wimberle/ME507-Term-Project/README.md

# ME507-Term-Project
This is the GitHub repository for the ME-507 Term Project at Cal Poly, SLO in spring 2023 under instructor Charlie Refvem
By: 
Matthew Wimberley and partner David Reo

The scope of this project was to create a robot for a competition of the game Hungry Hungry Hippos, where each robot must collect their team's respective color from an arena and deliver it to their respective home. A combination of line, ultrasonic, and color sensors in tandem with a custom designed PCB will accomplish this objective. The Bill of Materials, Schematic, PCB, Memorandum, and YouTube videos are outlined below.

## Reflection

While we fell short of our ambitious goal, this term project was ultimately very rewarding as I gained a new found respect for PCB manufacturing and the foresight that goes into designing well made boards. We were still able to get individual functionality of our line sensor, ultrasonic sensor, ball retrieving mechanism, and motor control as shown below.

## Bill of Materials

https://github.com/wimberle/ME507-Term-Project/blob/main/Bill%20of%20Materials.pdf

## Final Project Memorandum

https://github.com/wimberle/ME507-Term-Project/blob/main/Memorandum.pdf

## PCB & Schematic

https://github.com/wimberle/ME507-Term-Project/blob/main/SchematicAndPCB.pdf

## Top View of Final Results

https://github.com/wimberle/ME507-Term-Project/blob/main/IMG_4164.jpg

## YouTube Videos Demonstrating Our Robot's Functionalities
This video demonstrates line sensor functionality. 

https://youtu.be/W9VtT7H_Afg

This next video demonstates the capabilities of our DeadMan switch and ultrasonic sensor.

https://www.youtube.com/watch?v=X5WVTXg_MDY

This last video demonstrates the capabilities of our ball retrieving mechanism.

https://youtu.be/SO9tpv2Un_M
