wimberle/ME507-Term-Project/SchematicAndPCB.pdf

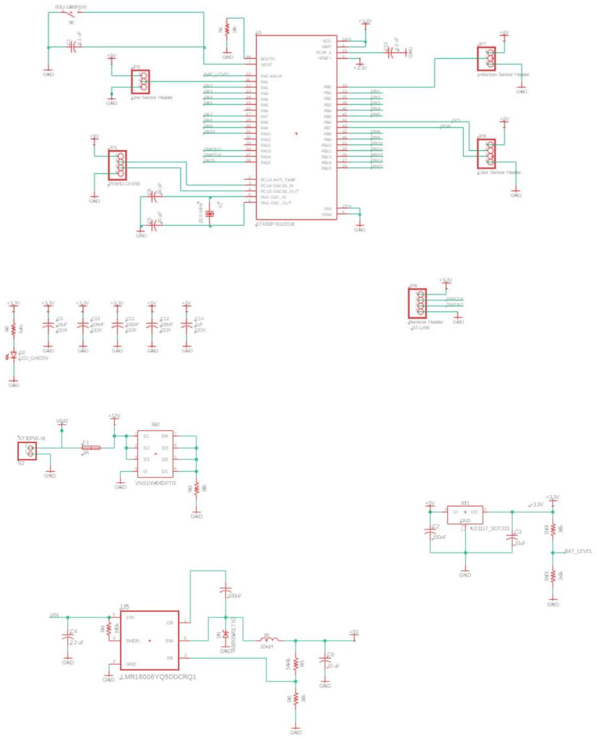
[picture p17: page 1]
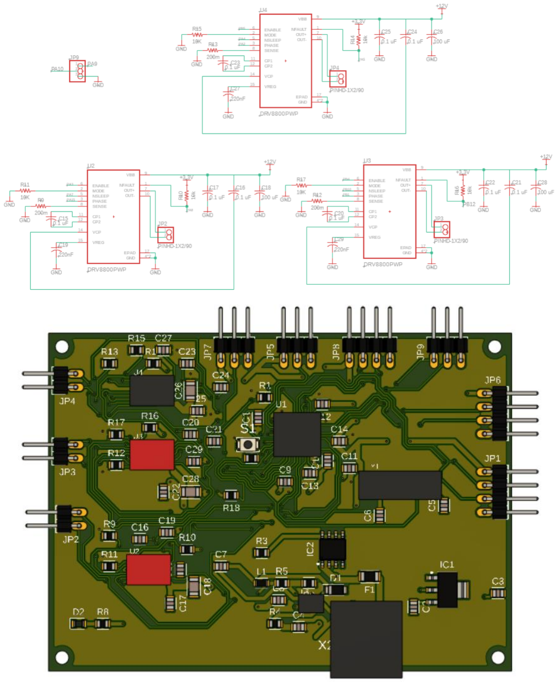
[picture p18: page 2]
