wimberle/ME507-Term-Project/Bill of Materials.pdf

Part | Quantity | Cost Per Part | Total Cost | Source
Wheels | 2 | $15 | 30 h ttp s://www.amazo n .co m/We ar-R e sistan t-Lu ggage -Su itcase -R e p lace me n t-Wh e e ls/d p /B 0 7 TVB C SG8 /re f= sr_ 1 _ 1 ?crid = 3 M GAQV6 EWZ5 6 V&ke ywo rd s= 3 + in ch + ru b b e r+ su itcase + wh e e l&q id = 1 6 8 1 6 9 5 5 7 7 &sp re fix= 3 + in ch + ru b b e r+ su itcase + wh e e l%2 C ap s%2 C 1 4 4 &sr= 8 -1 (https://www.amazon.com/Wear-Resistant-Luggage-Suitcase-Replacement-Wheels/dp/B07TVBCSG8)
Motor | 3 | $7 | 21 https://www.digikey.com/en/products/detail/johnson-motor/PC280LG-302/12723717
Solenoid | 1 | $10.00 | 10 h ttp s://www.amazo n .co m/M icro -Se rvo s-He lico p te r-Airp lan e -C o n tro ls/d p /B 0 7 M LR 1 4 9 8 /re f= sr_ 1 _ 1 3 ?crid = 3 B R 2 Z3 ISX G9 5 5 &ke ywo rd s= small%2 B me izu %2 B se rvo %2 B mo to r&q id = 1 6 8 5 0 5 0 5 8 2 &sp re fix= smallmie zu i%2 B se rvo %2 B mo to r%2 C ap s%2 C 1 2 4 &sr= 8 -1 3 &th = 1 (https://www.amazon.com/Micro-Servos-Helicopter-Airplane-Controls/dp/B07MLR1498)

# $24 for solenoid is a lot/find replacement

Battery | 1 | $19.52 | 19.52 https://www.digikey.com/en/products/detail/dantona-industries/L111A26-3-2-2WX/13692719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
Motor Driver | 3 | $3 | 9 https://www.digikey.com/en/products/detail/texas-instruments/DRV8800PWP/2231768
Ramp | 1 | $2 | 2 | 3D Print
Frame | 1 | $10 | 10 | 3D Print
Door | 1 | $3 | 5 | 3D Print
Line Detector | 1 | $3.50 | 3.5 ht t ps: / / www. digikey. com / en/ pr oduct s/ det ail/ spar kf un- elect r onics/ SEN- 11769/ 5768367?ut m _adgr oup=Evaluat ion%20Boar ds%20- %20Expansion%20Boar ds%2C%20Daught er %20Car ds&ut m _sour ce=google&ut m _m edium =cpc&ut m _cam paign=Shopping_Pr oduct _Developm ent %20Boar ds%2C%20Kit s%2C%20Pr ogr am m er s_NEW&ut m _t er m =&ut m _cont ent =Evaluat ion%20Boar ds%20- %20Expansion%20Boar ds%2C%20Daught er %20Car ds&gclid=CjwKCAjwue6hBhBVEiwA9YTx8LS0dkzGcZ3Wyx2eAM W9qquo8RI (https://www.digikey.com/en/products/detail/sparkfun-electronics/SEN-11769/5768367) f - m dxNuS_I pS9TbXvRE2NoE8XKhoCGVYQAvD_BwE
12V supply, cheap ultrasonic sensors exist but require two GPIO pins 1 | $10 | $10 | ht t ps: / / www. am azon. com / HC- SR04- HC- SR04P- Ult r asonic- Dist ance- M easur ing/ dp/ B07KNTQ4C2/ r ef =asc_df _B07KNTQ4C2/ ?t ag=hypr od- 20&linkCode=df 0&hvadid=647333030603&hvpos=&hvnet w=g&hvr and=2291005327543860054&hvpone=&hvpt wo=&hvqm t =&hvdev=c&hvdvcm dl=&hvlocint =&hvlocphy=1014232&hvt ar gid=pla- 2064869053590&psc=1&gclid=Cj0KCQjwyLGjBhDKARI sAFRNgW8m _aI EasnNRjI EwLBw6yC0RNSs2_7x5xQur pDTAC7FJ 7t HJ 2J uzr saAneGEALw_wcB (https://www.amazon.com/HC-SR04-HC-SR04P-Ultrasonic-Distance-Measuring/dp/B07KNTQ4C2?hvadid=647333030603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)
Color Detector | 1 | $8.70 | 8.7 ht t ps: / / www. digikey. com / en/ pr oduct s/ det ail/ seeed- t echnology- co. , - lt d/ 101020341/ 7423354?ut m _adgr oup=Seeed%20Technology%20Co. %2C%20LTD. &ut m _sour ce=google&ut m _m edium =cpc&ut m _cam paign=Shopping_DK%2BSupplier _Tier %201%20- %20Block%202&ut m _t er m =&ut m _cont ent =Seeed%20Technology%20Co. %2C%20LTD. &gclid=Cj0KCQjwj_ajBhCqARI sAA37s0zf F3wORvZOcQqSw- M SNSI s8Ed2EzgRBRlyFhDEt RLm 24Gm 5iKKlUQaAr BKEALw_wcB (https://www.digikey.com/en/products/detail/seeed-technology-co.,-ltd/101020341/7423354)
Transmitter/Receiver | 1 | $30 | $30 | h ttp s://www.amazo n .co m/HOB B YFANS-An ti-Jammin g-C o n tro l-Tran smitte r-R e ce ive r/d p /B 0 9 QHS9 4 NV/re f= sr_ 1 _ 7 ?crid = 1 I3 DGH5 3 E3 K 1 Z&ke ywo rd s= 2 + ch an n e l+ rc+ tran smitte r+ an d + re ce ive r&q id = 1 6 8 2 9 7 0 3 7 1 &sp re fix= 2 + ch an n e l+ rc+ tran smitte r+ an d + re ce ive r%2 C ap s%2 C 4 1 0 &sr= 8 -7 (https://www.amazon.com/HOBBYFANS-Anti-Jamming-Control-Transmitter-Receiver/dp/B09QHS94NV)
MOSFET | 1 | $1.28 | $1.28 | https://www.digikey.com/en/products/detail/diodes-incorporated/DMP2022LSS-13/1934991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
FUSE | 1 | $0.54 | $0.54 | https://www.digikey.com/en/products/detail/panasonic-electronic-components/ERB-RG3R00V/4280109
battery connector (XT-30) | 1 | $10.00 | $10.00 | ht t ps: / / www. am azon. com / OliYin- Connect or - Bat t er y- Air plane- Quadcopt er / dp/ B07P8M 44ZX/ r ef =sr _1_3_sspa?cr id=3V3M M FJ GXGJ BN&keywor ds=xt 30+connect or &qid=1683349130&s=t oys- and- gam es&spr ef ix=xt 30+connec%2Ct oys- and- gam es%2C459&sr =1- 3- spons&psc=1&spLa=ZW5jcnlwdGVkUXVhbGlm aWVyPUEySzJ EVEZYNE9I R1dVJ m VuY3J 5cHRlZElkPUEwM zA2M Tc5M 1BaT1BURUZES1QxWCZlbm NyeXB0ZWRBZElkPUEwNTM xODM wM UUyR0NBQ0J ZT0Um d2lkZ2V0Tm Ft ZT1zcF9hdGYm YWN0aW9uPWNsaWNr (https://www.amazon.com/OliYin-Connector-Battery-Airplane-Quadcopter/dp/B07P8M44ZX?s=toys-and-games) Um VkaXJ lY3Qm ZG9Ob3RM b2dDbGljaz10cnVl
Crystal | 1 | $0.20 | $0.20 | https://www.digikey.com/en/products/detail/ecs-inc/ECS-200-20-5PX-TR/696734
Linear regulator (5-3.3) | 1 | $0.66 | $0.66 | https://www.digikey.com/en/products/detail/stmicroelectronics/LD1117S33CTR/585765
capacitor for linear (1 uF) | 3 | $0.10 | $0.30 | https://www.digikey.com/en/products/detail/samsung-electro-mechanics/CL21B105KAFNNNE/3886724
Switcher (12V-5V) | 1 | $3.74 | $3.74 | https://www.digikey.com/en/products/detail/texas-instruments/LMR16006YQ5DDCRQ1/5395815
2.2 uF Cap | 5 | $0.10 | $0.50 | https://www.digikey.com/en/products/detail/samsung-electro-mechanics/CL21B225KAFNFNE/3888611
100 nF Cap | 10 | $0.10 | $1.00 | https://www.digikey.com/en/products/detail/samsung-electro-mechanics/CL21B104KBCNNNC/3886661
20 pF Cap | 5 | $0.10 | $0.50 | https://www.digikey.com/en/products/detail/kemet/C0805C200J5HAC7800/7948475
10 uF Cap | 10 | $0.10 | $1.00 | https://www.digikey.com/en/products/detail/samsung-electro-mechanics/CL21A106KOQNNNE/3886754
Resistor, 100k | 3 | $0.10 | $0.30 | https://www.digikey.com/en/products/detail/panasonic-electronic-components/ERA-6AEB104V/1465797
resistor, 10k | 10 | $0.10 | $1.00 | https://www.digikey.com/en/products/detail/yageo/RC0805JR-0710KL/728241
Resistor, 3.3k | 3 | $0.10 | $0.30 https://www.digikey.com/en/products/detail/te-connectivity-passive-product/CRGCQ0805J3K3/8576739
Resistor, 54.9k | 5 | $0.10 | $0.50 | https://www.digikey.com/en/products/detail/yageo/RC0805FR-0754K9L/728029
Resistor, 200m | 5 | $0.30 | $1.50 https://www.digikey.com/en/products/detail/susumu/RL1220S-R20-F/432484
100 uF Cap | 10 | $0.44 | $4.40 https://www.digikey.com/en/products/detail/murata-electronics/GRM31CD80J107MEA8K/13905021
Reset Switch | 1 | $1.00 | $1.00 | https://www.digikey.com/en/products/detail/omron-electronics-inc-emc-div/B3U-1000P/1534338
Inductor, 10 mH | 1 | $3.03 | $3.03 | https://www.digikey.com/en/products/detail/taiyo-yuden/LBR2012T100K/1788937
Schottkey Diode | 1 | $0.36 | $0.36 | https://www.digikey.com/en/products/detail/diodes-incorporated/FES1DE/16375492
LED | 3 | $0.28 | $0.84 | https://www.digikey.com/en/products/detail/liteon/LTST-C171KGKT/386799
3 pin header | 4 | $1.63 | $6.52 https://www.digikey.com/en/products/detail/mill-max-manufacturing-corp/380-10-103-00-002000/8019516
2 pin header | 4 | $1.23 | $4.92 https://www.digikey.com/en/products/detail/mill-max-manufacturing-corp/380-10-102-00-002000/8019515
4 pin header | 4 | $1.80 | $7.20 https://www.digikey.com/en/products/detail/mill-max-manufacturing-corp/380-10-104-00-002000/8019517
Grand Total | 95 | | $198.19
