wimberle/ME507-Term-Project/main.c

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
/* Includes ------------------------------------------------------------------*/
#include "main.h"

/* USER CODE BEGIN Includes */
#include "motor_driver.h"
#include "string.h"
#include "stdio.h"
#include "ctype.h"


/* USER CODE END Includes */

I2C_HandleTypeDef hi2c1;

TIM_HandleTypeDef htim1;
TIM_HandleTypeDef htim2;
TIM_HandleTypeDef htim5;

void SystemClock_Config(void);
static void MX_GPIO_Init(void);
static void MX_TIM2_Init(void);
static void MX_TIM1_Init(void);
static void MX_I2C1_Init(void);
static void MX_TIM5_Init(void);
/* USER CODE BEGIN 0 */
void delay (uint16_t time)
{
	__HAL_TIM_SET_COUNTER(&htim1, 0);
	while (__HAL_TIM_GET_COUNTER (&htim1) < time);
}

uint32_t IC_Val1 = 0;
uint32_t IC_Val2 = 0;
uint32_t Difference = 0;
uint8_t Is_First_Captured = 0;
uint8_t Is_Dead = 0;
uint8_t Start = 0;
uint32_t trig = 0;
uint8_t Distance = 0;
uint8_t L1 = 0;
uint8_t L2 = 0;

#define TRIG_PIN GPIO_PIN_9 // make sure this is A9
#define TRIG_PORT GPIOA
#define LS_PORT GPIOB
#define LS_1 GPIO_PIN_9
#define LS_2 GPIO_PIN_8


void HAL_TIM_IC_CaptureCallback(TIM_HandleTypeDef *htim)
// figure out how to put the dead man's switch in this same callback
{

	if (htim == &htim5) //timer 5 is for dead man's switch
	{
		// maybe do a further check for channel
		trig = HAL_TIM_ReadCapturedValue(&htim5, TIM_CHANNEL_2)/100; // has to be on channel 2
		if (trig > 1700)
		{
			Is_Dead = 1;
			// some other code to kill the robot
			// maybe turn off motor drivers
		}
		if (trig < 1000 && trig!=0)
		{
			Start = 1;
			// start robot state
		}
	}

	if (htim == &htim1) // timer 1 is for the ultrasonic sensor
	{
		if (htim->Channel == HAL_TIM_ACTIVE_CHANNEL_1) // check if interpret source is channel 1
		{
			if (Is_First_Captured ==0) //if the first value is not captured
			{
				IC_Val1 = HAL_TIM_ReadCapturedValue(htim, TIM_CHANNEL_1); // read the first value
				Is_First_Captured = 1; // set the first captured as true
				// now change polarity to falling edge
				__HAL_TIM_SET_CAPTUREPOLARITY(htim, TIM_CHANNEL_1, TIM_INPUTCHANNELPOLARITY_FALLING);

			}
			else if (Is_First_Captured==1)
			{
				IC_Val2 = HAL_TIM_ReadCapturedValue(htim, TIM_CHANNEL_1); // read second value
				__HAL_TIM_SET_COUNTER(htim, 0);

				if (IC_Val2 > IC_Val1)
				{
					Difference = IC_Val2 - IC_Val1;
				}
				else if (IC_Val1 > IC_Val2)
				{
					Difference = (0xffff - IC_Val1) + IC_Val2;
				}

				Distance = Difference * .034/2; //FORMULA IN DATASHEET
				if (Distance<5 && Distance != 0 )
				{
					Is_Dead = 1; //KILL
				}
				Is_First_Captured = 0; // set it back to false

				//set polarity to rising edge
				__HAL_TIM_SET_CAPTUREPOLARITY(htim, TIM_CHANNEL_1, TIM_INPUTCHANNELPOLARITY_RISING);
				__HAL_TIM_DISABLE_IT(&htim1, TIM_IT_CC1);
			}
		}
	}

}

void HCSR04_Read (void)
{
	HAL_GPIO_WritePin(TRIG_PORT, TRIG_PIN, GPIO_PIN_SET); // pull TRIG pin HIGH
	delay(10); // wait for 10 us (based on above delay function)
	HAL_GPIO_WritePin(TRIG_PORT, TRIG_PIN, GPIO_PIN_RESET); //pull the TRIG pin low

	__HAL_TIM_ENABLE_IT(&htim1, TIM_IT_CC1);
}
/* USER CODE END 0 */

/**
  * @brief  The application entry point.
  * @retval int
  */
int main(void)
{
  /* MCU Configuration--------------------------------------------------------*/

  /* Reset of all peripherals, Initializes the Flash interface and the Systick. */
  HAL_Init();

  /* Configure the system clock */
  SystemClock_Config();

  /* Initialize all configured peripherals */
  MX_GPIO_Init();
  MX_TIM2_Init();
  MX_TIM1_Init();
  MX_I2C1_Init();
  MX_TIM5_Init();
  /* USER CODE BEGIN 2 */

  HAL_TIM_IC_Start_IT(&htim1, TIM_CHANNEL_1);
  HAL_TIM_IC_Start_IT(&htim5, TIM_CHANNEL_1); //start tim 5!!!!!
  HAL_TIM_IC_Start(&htim5, TIM_CHANNEL_2);

  motor_driver_t motor1 = {&htim2, TIM_CHANNEL_1, TIM_CHANNEL_2}; //pass values into struct
  motor_driver_t motor2 = {&htim2, TIM_CHANNEL_3, TIM_CHANNEL_4};


  /* USER CODE END 2 */

  /* Infinite loop */
  /* USER CODE BEGIN WHILE */
  while (1)
  {
    /* USER CODE END WHILE */

    /* USER CODE BEGIN 3 */
	  HCSR04_Read();
	  HAL_Delay(200); //200 ms delay
	  L1 = HAL_GPIO_ReadPin(LS_PORT, LS_1);
	  L2 = HAL_GPIO_ReadPin(LS_PORT, LS_2);

	  if (Start == 1)
	  {
		  enable(&motor1);
		  enable(&motor2);
		  Is_Dead = 0;
		  Start = 0;
	  }
	  if (Is_Dead == 1)
	  {
		  disable(&motor1);
		  disable(&motor2);
		  Start = 0;
		  Is_Dead = 0;
	  }
	  // L1 is closest to the Right wheel facing out (motor1)
	  // L2 is closest to the Left wheel facing out (motor2)

	  if(L1 == 0 && L2 ==0)
	  {
		  drive(&motor1, -10);
		  drive(&motor2, -10);
	  }
	  if(L1 == 0 && L2 ==1)
	  {

		  drive(&motor1, -5);
		  drive(&motor2, 10);

	  }
	  if(L1 == 1 && L2 ==0)
	  {
		  drive(&motor1, 10);
		  drive(&motor2, -5);
	  }
	  if(L1 == 1 && L2 ==1)
	  {
		  drive(&motor1, -10);
		  drive(&motor2, -10);
	  }

	  // some code to test duty cycle:


  }
  /* USER CODE END 3 */
}

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
