wimberle/ME507-Term-Project/Robo_Collector.ioc

Mcu.UserName=STM32F411CEUx
PA0-WKUP.Signal=S_TIM5_CH1
PA1.Signal=S_TIM2_CH2
PA13.Signal=SYS_JTMS-SWDIO
PA14.Signal=SYS_JTCK-SWCLK
PA2.Signal=S_TIM2_CH3
PA3.Signal=S_TIM2_CH4
PA5.Signal=S_TIM2_CH1_ETR
PA8.Signal=S_TIM1_CH1
PA9.Signal=GPIO_Output
PB6.Signal=I2C1_SCL
PB7.Signal=I2C1_SDA
PB9.Signal=GPIO_Input
PC13-ANTI_TAMP.GPIO_Label=LED
PC13-ANTI_TAMP.Signal=GPIO_Input
