wimberle/ME507-Term-Project/IMG_4164.jpg

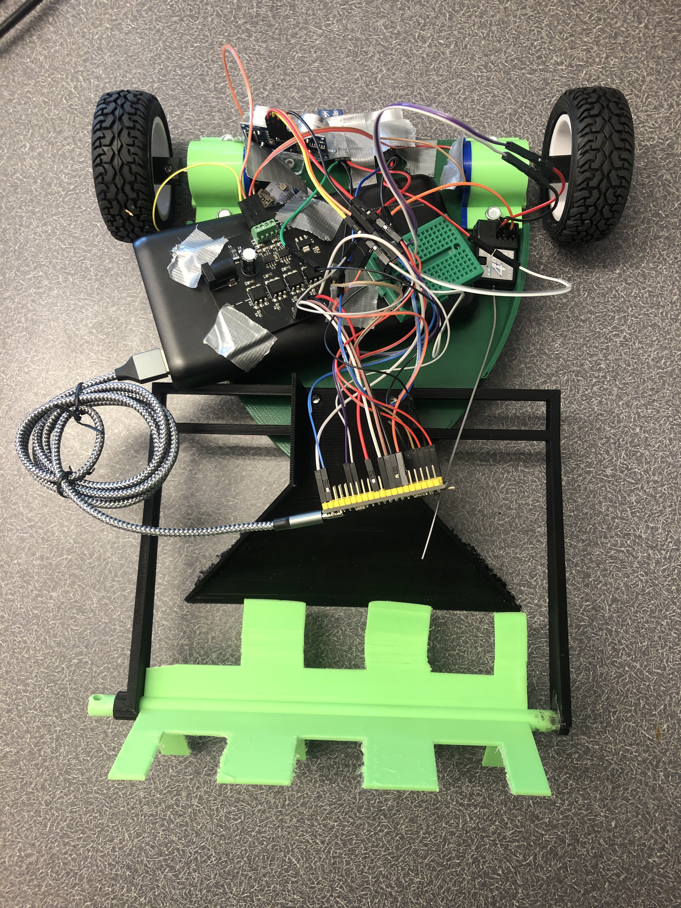
IMG_4164.jpg
